syt83/2026ESWContest_free_Following_cart/docs/BOM.md

# Bill of Materials (BOM)

> Following-Cart 프로젝트 부품 목록

---

## 메인 컴퓨팅

| 부품명 | 모델명 | 역할 | 수량 | 단가 | 합계 |
|---|---|---|---|---|---|
| AI 처리 보드 | Raspberry Pi 5 (8GB) | LiDAR 처리, UWB 위치추정, Navigation2, 사용자 추종 알고리즘 | 1 | | |
| 모터 제어 보드 | Arduino Uno | 모터 제어, Encoder 처리, PID 제어 | 1 | | |

---

## 센서

| 부품명 | 모델명 | 역할 | 수량 | 단가 | 합계 |
|---|---|---|---|---|---|
| UWB 모듈 | Arduino Stella (ABX00131) | 사용자 스마트폰과의 거리 측정 (range-only) | 1 | | |
| LiDAR | YDLIDAR X4 Pro (12cm~10m) | 장애물 탐지 | 1 | | |
| RFID/NFC 모듈 | RFID-RC522 [SZH-EK040] | 사용자 스마트폰 인증 및 잠금/해제 | 1 | | |
| IMU | MPU6050 | 자세 추정, EKF Sensor Fusion | 1 | | |
| OLED 디스플레이 | SSD1306 | 상태 표시 | 1 | | |

> USB Camera는 설계에서 제외됨 (RPi5는 GPU 미탑재로 실시간 딥러닝 인식에 부적합, 장애물 회피는 LiDAR만으로 처리)

---

## 구동부

| 부품명 | 모델명 | 역할 | 수량 | 단가 | 합계 |
|---|---|---|---|---|---|
| 엔코더 DC 모터 (후륜) | 42-775B | 구동 | 2 | | |
| 모터 드라이버 | MD20A | DC 모터 PWM 제어 | 1 | | |
| 바퀴 | - | 후륜 구동 / 전륜 캐스터 | 4 | | |

---

## 전원

| 부품명 | 모델명 | 역할 | 수량 | 단가 | 합계 |
|---|---|---|---|---|---|
| 보드용 배터리 | Li-Po 14.8V (4S) 1000mAh | RPi5, LiDAR 보조전원, Stella, IMU, RFID, 디스플레이 공급 | 1 | | |
| 모터용 배터리 | JIPOWER Li-Po 22.2V (6S) 5200mAh 35C | DC 모터(MD20A), 서보(UBEC 경유) 공급 | 1 | | |
| RPi5 전용 DC-DC 컨버터 (USB-PD 트리거 포함) | SZH-EK366 | RPi5 전용 5V/5A 공급 (PD 프로토콜 협상 필요) | 1 | | |
| DC-DC 컨버터 | SZH-EKBD-066 | LiDAR USB_PWR(보조전원) 공급 | 1 | | |
| 전압 표시 모듈 | FND 전압표시 | 배터리 전압 모니터링 | 2 | | |

> - 보드용/모터용 배터리 전원 라인은 분리하되, 데이터 통신(LiDAR, Arduino 등)을 위해 모든 기기의 GND는 공통으로 연결.
> - 보드용 배터리(1000mAh) 기준 실사용 런타임은 약 35~50분으로 추정되어, README의 "연속 운행 2시간" 목표 대비 용량 증설(3000mAh 이상 권장) 또는 배터리 교체 운용 검토 필요.
> - 42-775B 모터, MD20A 드라이버의 정격 전압이 모터용 배터리(22.2V, 풀충전 시 25.2V)와 맞는지 스펙시트 확인 필요.

---

## 합계

| 항목 | 금액 |
|---|---|
| 총 부품 비용 | |
| 기타 (케이블, 커넥터 등) | |
| **총합** | |

---

> **※ 비고**
> - Arduino 모델(Uno/Mega), RPi5 전용 DC-DC 컨버터, UBEC 모델은 선정 후 업데이트 예정
> - 단가는 구매 시점 기준
