syt83/2026ESWContest_free_Following_cart/hardware/kicad/following-cart.kicad_sch

## KiCad design hardware/kicad/following-cart.kicad_sch (2026-08-01)

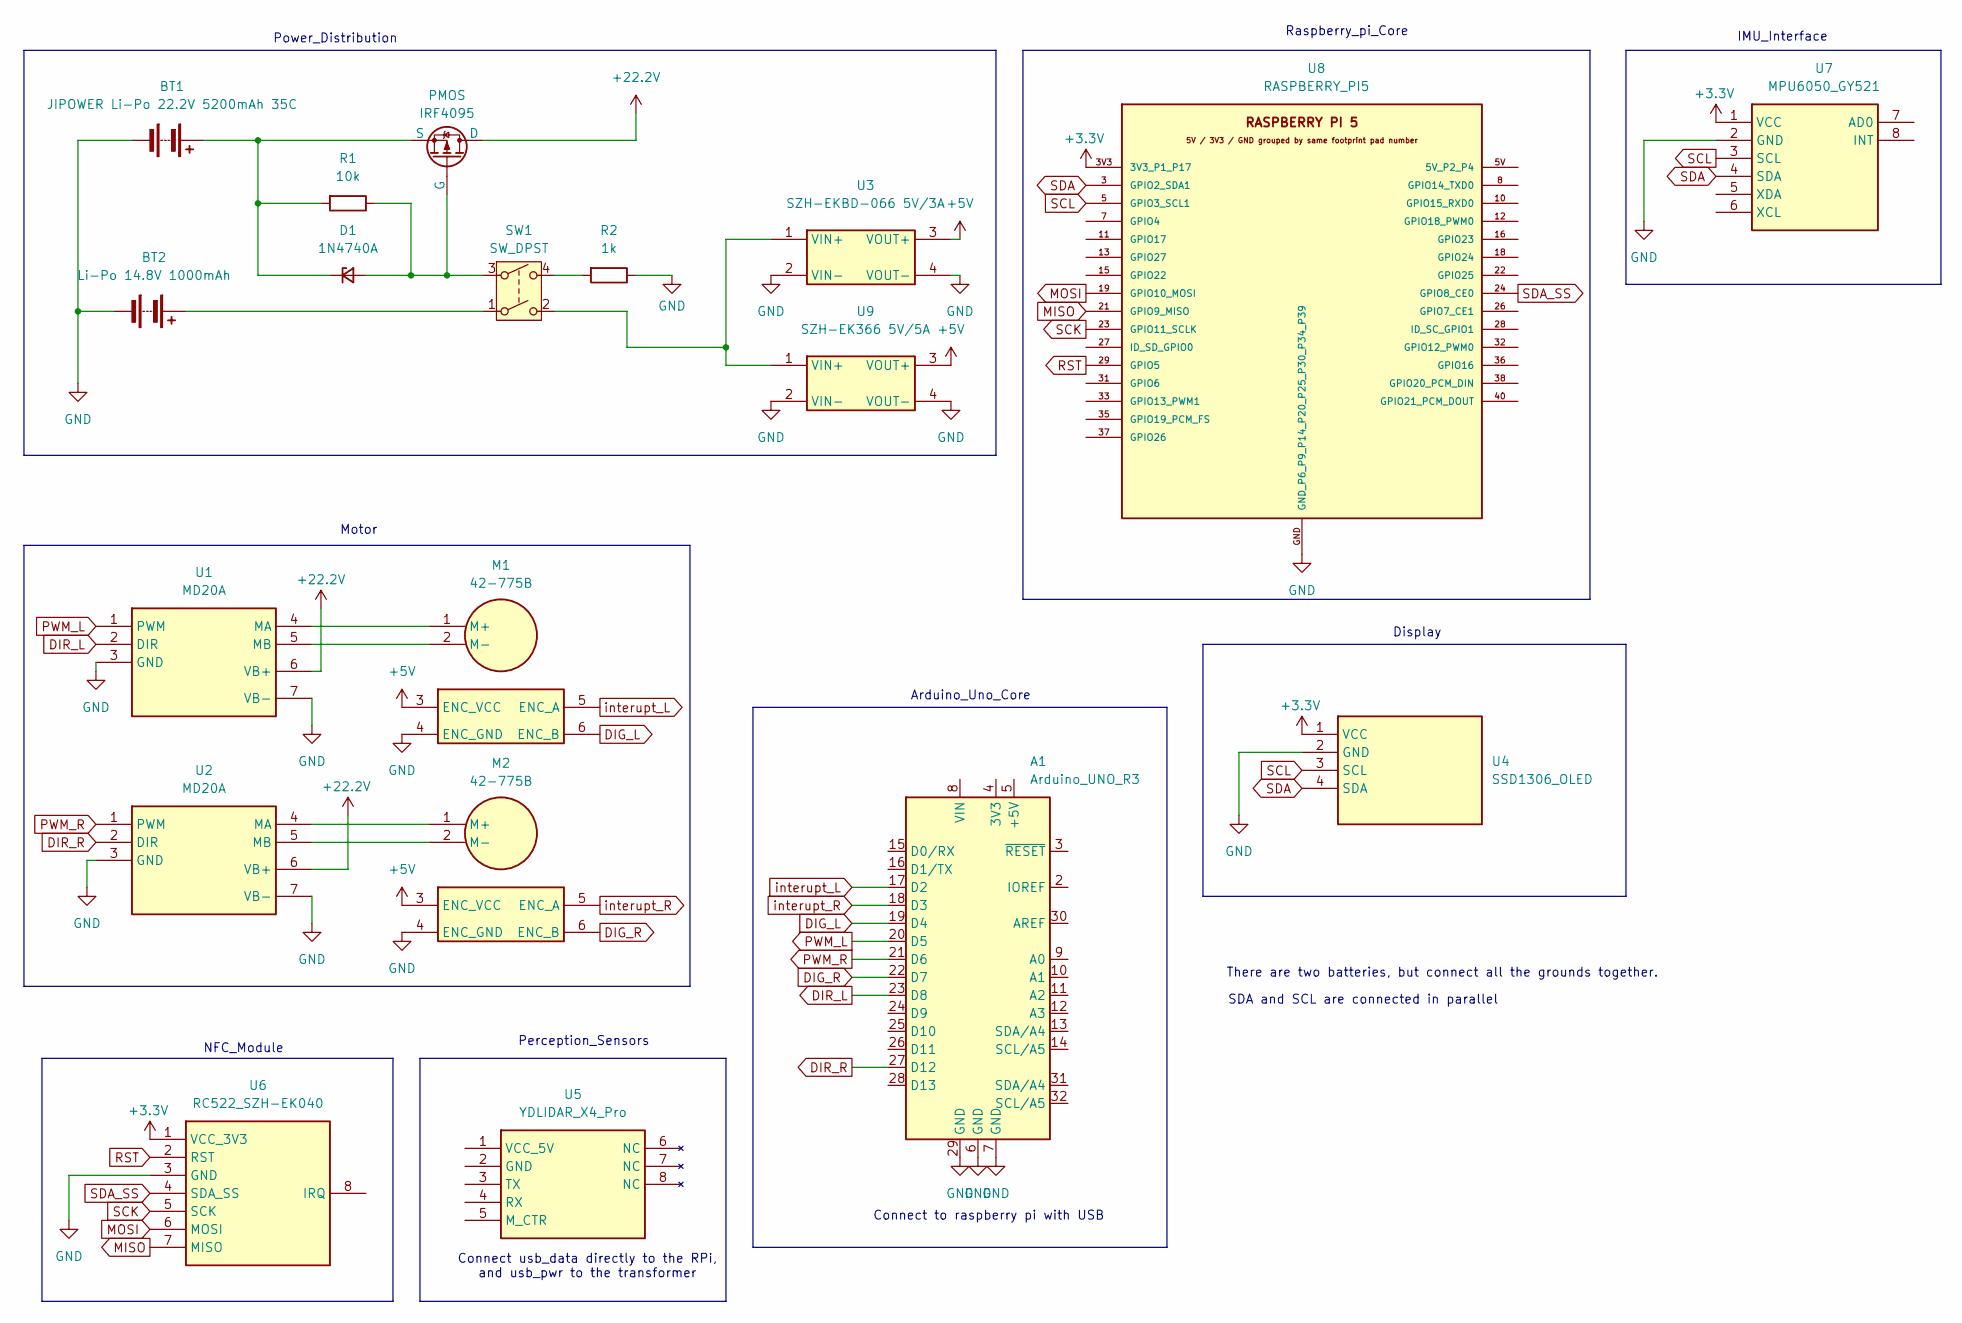
[picture p1: schematic following-cart.kicad_sch]

Parts:
A1: Arduino_UNO_R3
BT1: JIPOWER Li-Po 22.2V 5200mAh 35C
BT2: Li-Po 14.8V 1000mAh
D1: 1N4740A
IRF4095: PMOS
M1, M2: 42-775B
R1: 10k
R2: 1k
SW1: SW_DPST
U1, U2: MD20A
U3: SZH-EKBD-066 5V/3A
U4: SSD1306_OLED
U5: YDLIDAR_X4_Pro
U6: RC522_SZH-EK040
U7: MPU6050_GY521
U8: RASPBERRY_PI5
U9: SZH-EK366 5V/5A

Connections:
+3.3V: U4.1 (VCC), U6.1 (VCC_3V3), U7.1 (VCC), U8.3V3 (3V3_P1_P17)
+5V: M1.3 (ENC_VCC), M2.3 (ENC_VCC), U3.3 (VOUT+), U9.3 (VOUT+)
+22.2V: IRF4095.1 (D), U1.6 (VB+), U2.6 (VB+)
DIG_L: A1.19 (D4), M1.6 (ENC_B)
DIG_R: A1.22 (D7), M2.6 (ENC_B)
DIR_L: A1.23 (D8), U1.2 (DIR)
DIR_R: A1.27 (D12), U2.2 (DIR)
GND: A1.6 (GND), A1.7 (GND), A1.29 (GND), BT1.2 (-), BT2.2 (-), M1.4 (ENC_GND), M2.4 (ENC_GND), R2.1, U1.3 (GND), U1.7 (VB-), U2.3 (GND), U2.7 (VB-), U3.2 (VIN-), U3.4 (VOUT-), U4.2 (GND), U6.3 (GND), U7.2 (GND), U8.GND (GND_P6_P9_P14_P20_P25_P30_P34_P39), U9.2 (VIN-), U9.4 (VOUT-)
MISO: U6.7 (MISO), U8.21 (GPIO9_MISO)
MOSI: U6.6 (MOSI), U8.19 (GPIO10_MOSI)
unnamed: BT1.1 (+), D1.1 (K), IRF4095.3 (S), R1.2
unnamed: BT2.1 (+), SW1.1
unnamed: D1.2 (A), IRF4095.2 (G), R1.1, SW1.3
unnamed: M1.1 (M+), U1.4 (MA)
unnamed: M1.2 (M-), U1.5 (MB)
unnamed: M2.1 (M+), U2.4 (MA)
unnamed: M2.2 (M-), U2.5 (MB)
unnamed: R2.2, SW1.4
unnamed: SW1.2, U3.1 (VIN+), U9.1 (VIN+)
PWM_L: A1.20 (D5), U1.1 (PWM)
PWM_R: A1.21 (D6), U2.1 (PWM)
RST: U6.2 (RST), U8.29 (GPIO5)
SCK: U6.5 (SCK), U8.23 (GPIO11_SCLK)
SCL: U4.3 (SCL), U7.3 (SCL), U8.5 (GPIO3_SCL1)
SDA: U4.4 (SDA), U7.4 (SDA), U8.3 (GPIO2_SDA1)
SDA_SS: U6.4 (SDA_SS), U8.24 (GPIO8_CE0)
interupt_L: A1.17 (D2), M1.5 (ENC_A)
interupt_R: A1.18 (D3), M2.5 (ENC_A)

Notes on the sheet:
Motor
Power_Distribution
Raspberry_pi_Core
Perception_Sensors
NFC_Module
Connect to raspberry pi with USB
Connect usb_data directly to the RPi, and usb_pwr to the transformer
IMU_Interface
Display
There are two batteries, but connect all the grounds together.
SDA and SCL are connected in parallel
Arduino_Uno_Core
