syt83/2026ESWContest_free_Following_cart/(commit log)

2026-07-11 docs: Add BOM.md
2026-08-01 Update hardware file
    [following-cart.kicad_sch]
2026-08-12 Update motor issue
2026-08-25 add motor control
2026-08-31 Update schematic and Hardware-Issue
